SelimEldreeny111/Laser_Inter_Satellite_Link_Testing/docs/STM32F401_DRV8825_realistic_connection.png

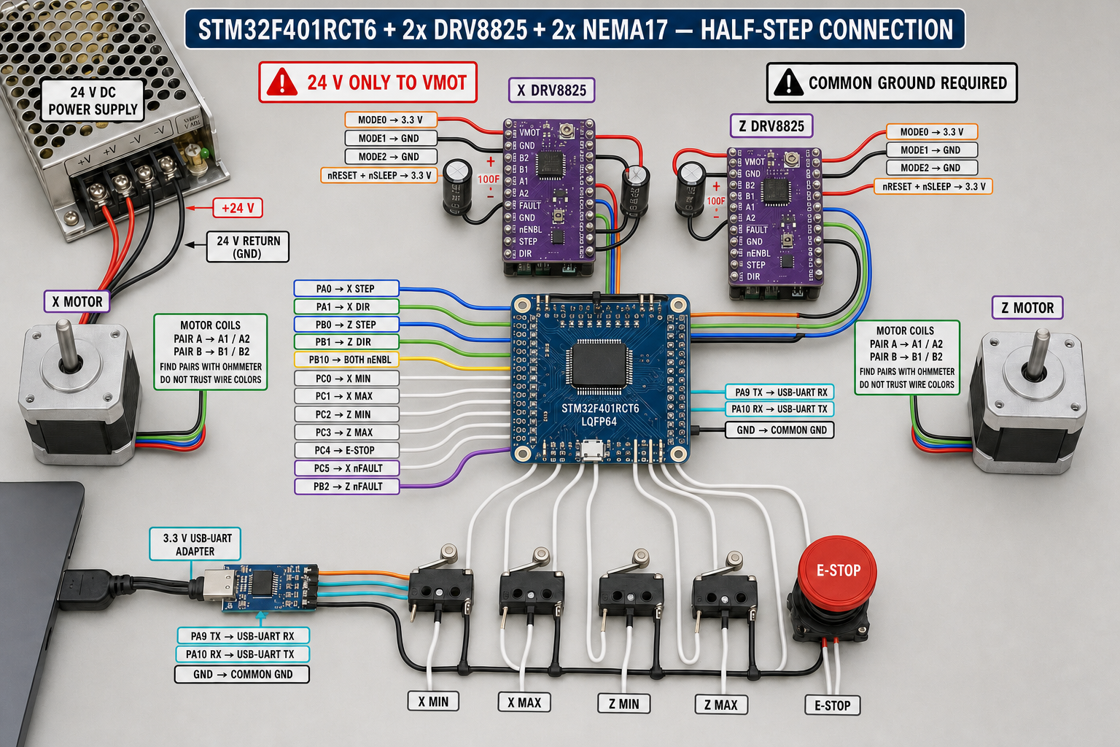
docs/STM32F401_DRV8825_realistic_connection.png
