SelimEldreeny111/Laser_Inter_Satellite_Link_Testing/(commit log)

2026-09-25 release: publish integrated laser link test system
2026-09-25 ci: pin validated STM32 core version
